pschatzmann/I2SBoard/sim/sim.png

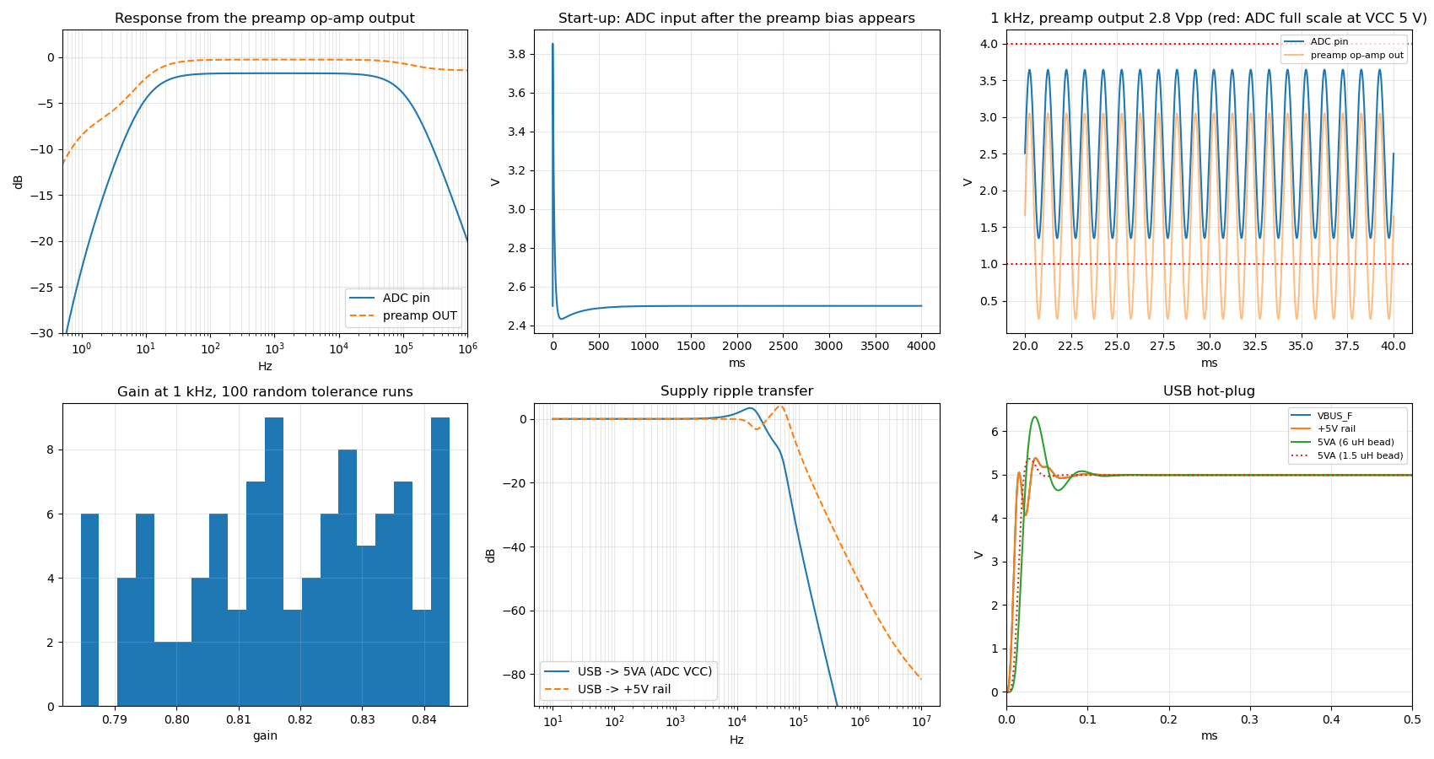
sim/sim.png
