pschatzmann/I2SBoard/fab/BOM.csv

Comment | Designator | Footprint | LCSC Part #
USB-C (power only) | J4 | USB_C_Receptacle_HRO_TYPE-C-31-M-12 | C165948
5.1k | R1,R2 | R_0603_1608Metric | C23186
500mA PTC | F1 | Fuse_1206_3216Metric | C163512
CDSOD323-T05C | D1 | D_SOD-323 | C711706
10uF | C1,C3,C5,C8 | C_0805_2012Metric | C15850
100nF | C2,C7,C9,C10 | C_0603_1608Metric | C1591
B5819W | D4 | D_SOD-123 | C64885
1k | R3 | R_0603_1608Metric | C21190
green | D2 | LED_0603_1608Metric | C2289
ME6211C33M5 | U1 | SOT-23-5 | C82942
600R@100MHz | FB1 | L_0603_1608Metric | C19330
PCM1808PWR | U2 | TSSOP-14_4.4x5mm_P0.65mm | C55513
33R | R6 | R_0603_1608Metric | C23140
5.6k | R4 | R_0603_1608Metric | C23189
1uF | C11 | C_0603_1608Metric | C15849
220pF | C13 | C_0603_1608Metric | C156398
