pschatzmann/I2SBoard/(list of files, drawings)

Other design files:
kicad/I2SBoard.dsn
