pschatzmann/I2SBoard/kicad/I2SBoard.kicad_pcb

## KiCad design kicad/I2SBoard.kicad_pcb (2026-11-03)

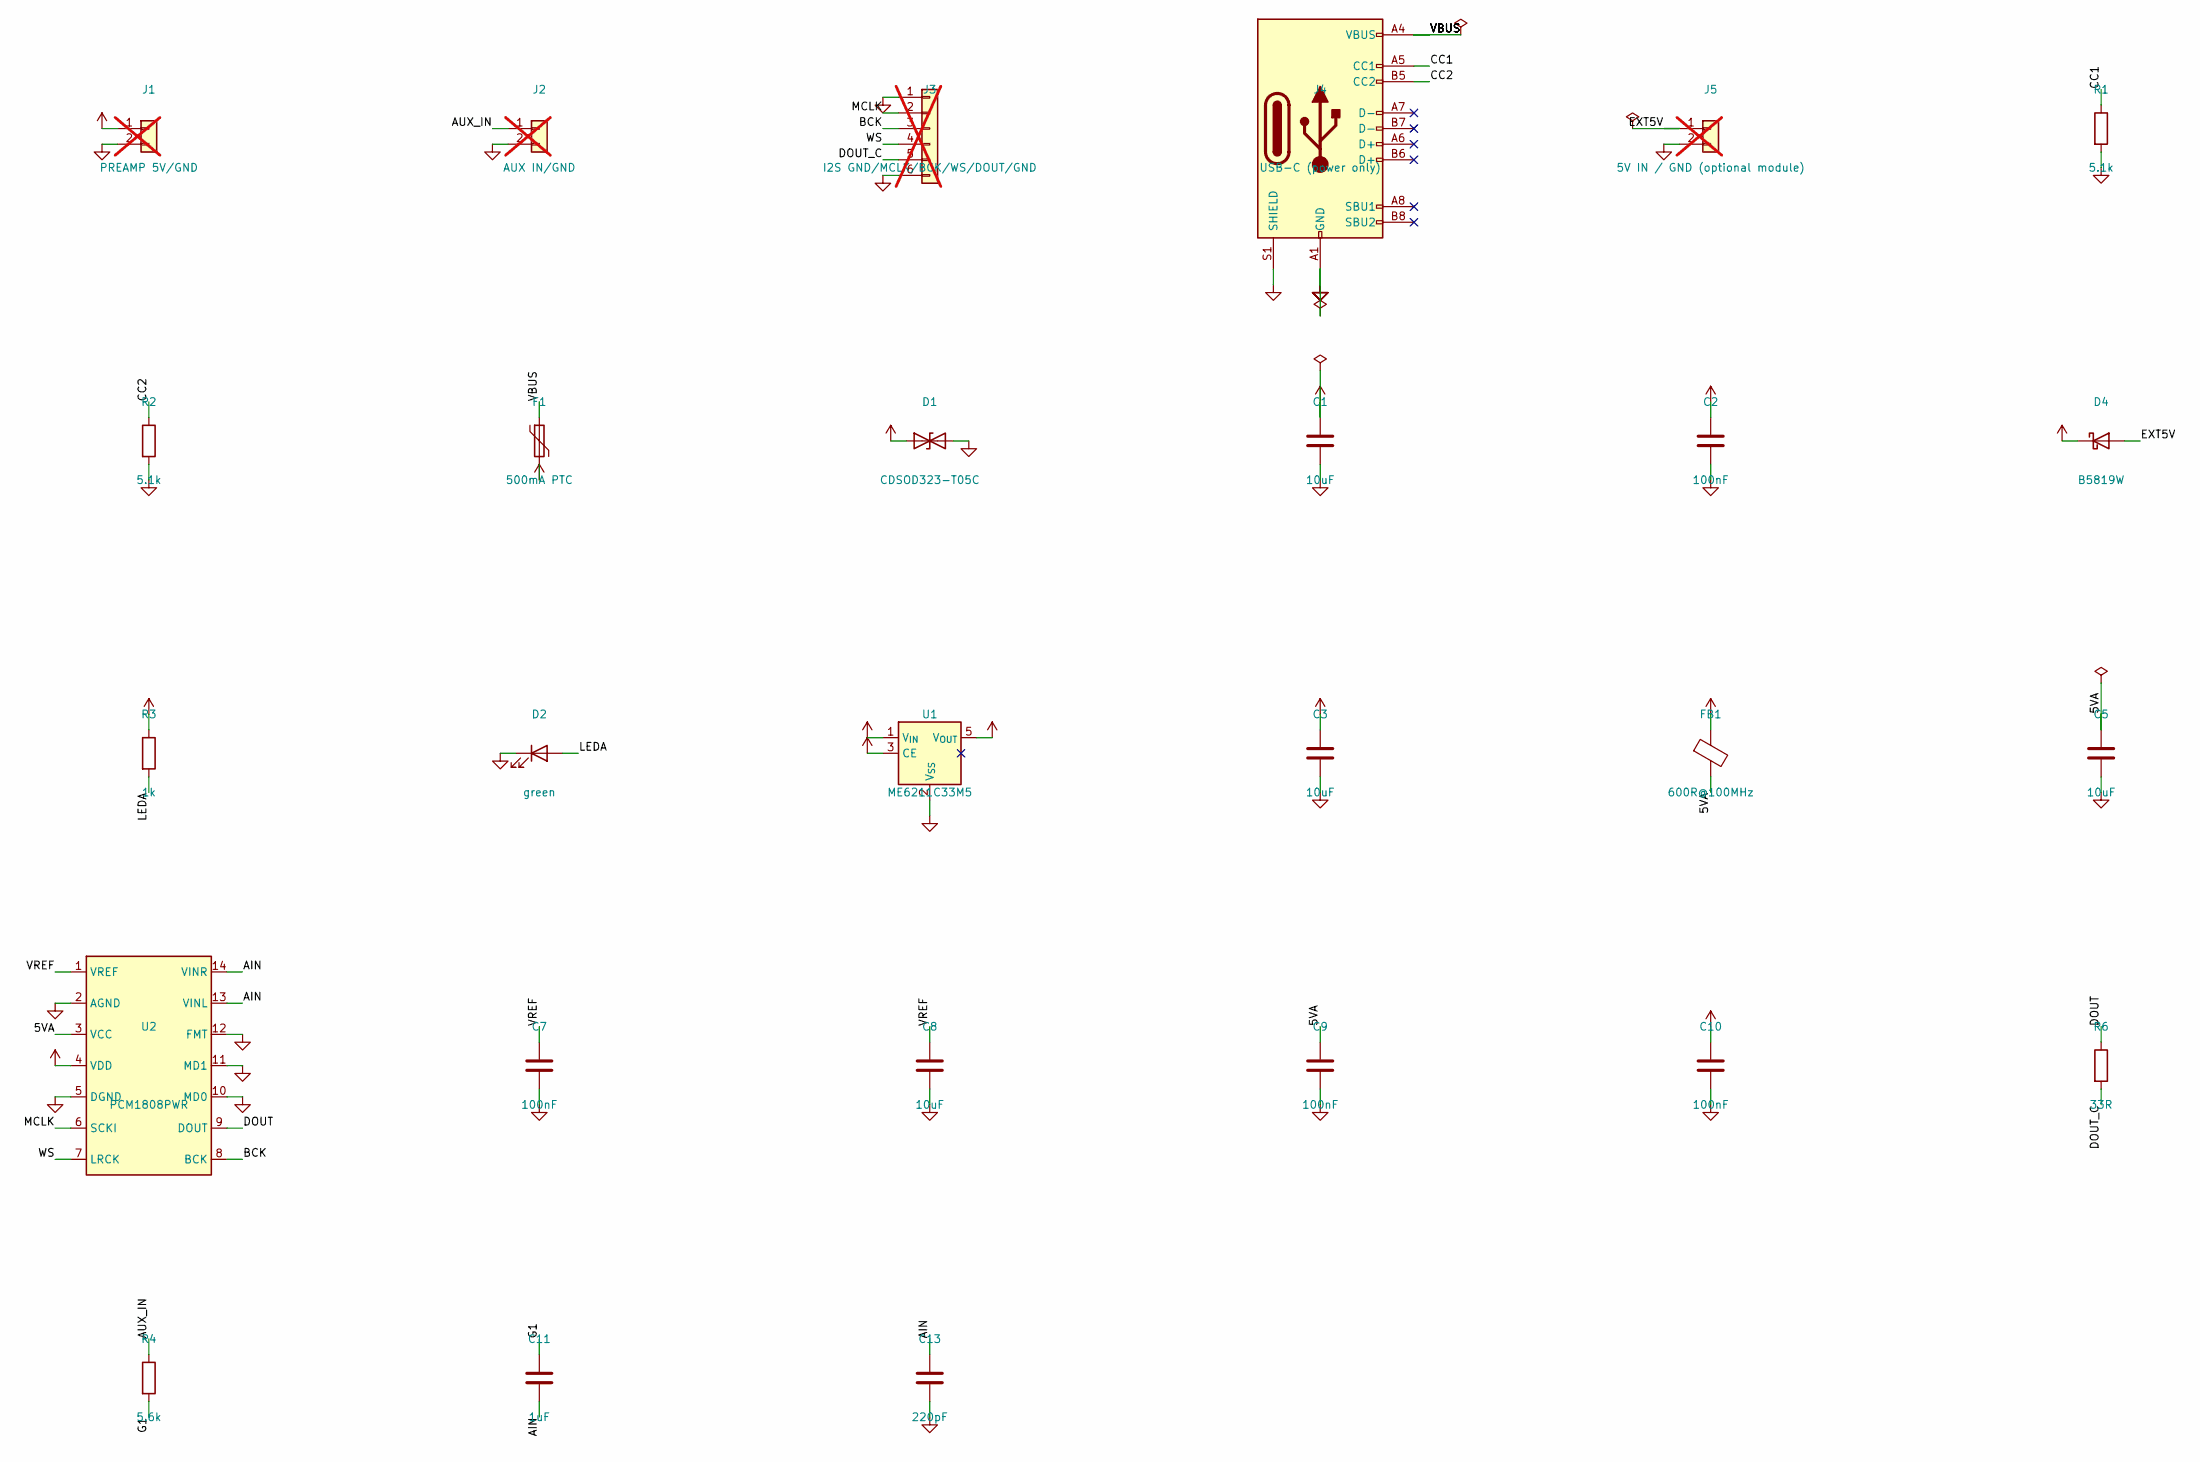
[picture p3: schematic I2SBoard.kicad_sch, I2SBoard: stereo I2S ADC for Guitar/Piezo preamps]

Parts:
C1, C3, C5, C8: 10uF; C_0805_2012Metric
C2, C7, C9, C10: 100nF; C_0603_1608Metric
C11: 1uF; C_0603_1608Metric
C13: 220pF; C_0603_1608Metric
D1: CDSOD323-T05C; D_SOD-323
D2: green; LED_0603_1608Metric
D4: B5819W; D_SOD-123
F1: 500mA PTC; Fuse_1206_3216Metric
FB1: 600R@100MHz; L_0603_1608Metric
J1: PREAMP 5V/GND; PinHeader_1x02_P2.54mm_Vertical; not fitted
J2: AUX IN/GND; PinHeader_1x02_P2.54mm_Vertical; not fitted
J3: I2S GND/MCLK/BCK/WS/DOUT/GND; PinHeader_1x06_P2.54mm_Vertical; not fitted
J4: USB-C (power only); USB_C_Receptacle_HRO_TYPE-C-31-M-12
J5: 5V IN / GND (optional module); PinHeader_1x02_P2.54mm_Vertical; not fitted
R1, R2: 5.1k; R_0603_1608Metric
R3: 1k; R_0603_1608Metric
R4: 5.6k; R_0603_1608Metric
R6: 33R; R_0603_1608Metric
U1: ME6211C33M5; SOT-23-5
U2: PCM1808PWR; TSSOP-14_4.4x5mm_P0.65mm

Connections:
5VA: C5.1, C9.1, FB1.2, U2.3 (VCC)
+3V3: C3.1, C10.1, U1.5 (V_{OUT}), U2.4 (VDD)
+5V: C1.1, C2.1, D1.1 (A1), D4.1 (K), F1.2, FB1.1, J1.1, R3.1, U1.1 (V_{IN}), U1.3 (CE)
AIN: C11.2, C13.1, U2.13 (VINL), U2.14 (VINR)
AUX_IN: J2.1, R4.1
BCK: J3.3, U2.8 (BCK)
CC1: J4.A5 (CC1), R1.1
CC2: J4.B5 (CC2), R2.1
DOUT: R6.1, U2.9 (DOUT)
DOUT_C: J3.5, R6.2
EXT5V: D4.2 (A), J5.1
G1: C11.1, R4.2
GND: C1.2, C2.2, C3.2, C5.2, C7.2, C8.2, C9.2, C10.2, C13.2, D1.2 (A2), D2.1 (K), J1.2, J2.2, J3.1, J3.6, J4.A1 (GND), J4.A12 (GND), J4.B1 (GND), J4.B12 (GND), J4.S1 (SHIELD), J5.2, R1.2, R2.2, U1.2 (V_{SS}), U2.2 (AGND), U2.5 (DGND), U2.10 (MD0), U2.11 (MD1), U2.12 (FMT)
LEDA: D2.2 (A), R3.2
MCLK: J3.2, U2.6 (SCKI)
VBUS: F1.1, J4.A4 (VBUS), J4.A9 (VBUS), J4.B4 (VBUS), J4.B9 (VBUS)
VREF: C7.1, C8.1, U2.1 (VREF)
WS: J3.4, U2.7 (LRCK)

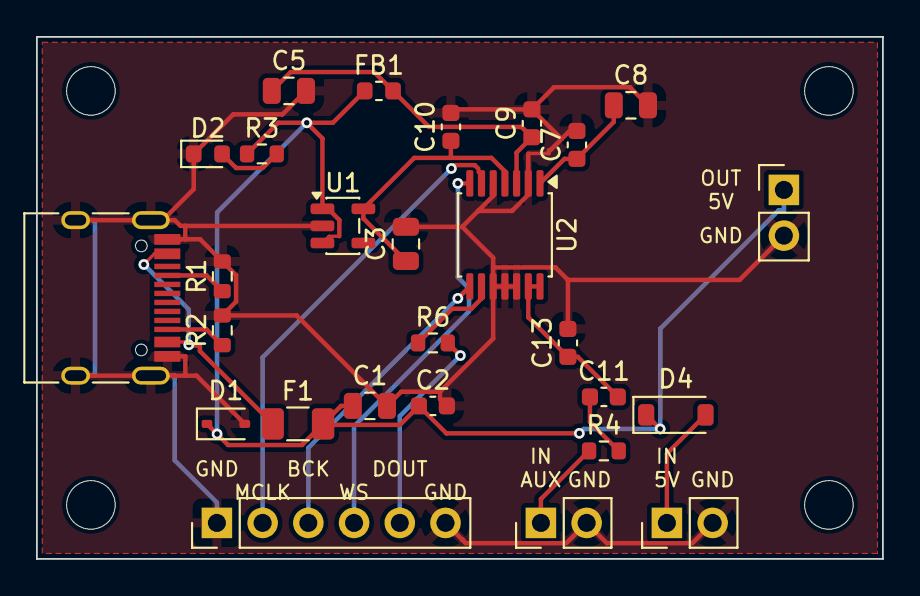
[picture p4: board I2SBoard.kicad_pcb from above]

Board: 2 copper layers, 47.0 x 29.0 mm, 31 parts (0 on the bottom side), 18 nets.

Other parts of the board:
H1, H2, H3, H4: MountingHole_2.7mm_M2.5
